tle9/Wall-E-Robot/Project Proposal/CS3651 Project Proposal.pdf

# CS 3651 - Prototyping Intelligent Devices Project Proposal Wall-E

### Names: Nithya Jayakumar, Tri Le

### March 4, 2024

## 1 Description

The project aims to construct a functional small-scale robot inspired by Wall-E, with a focus on mobility through the integration of distance sensors. The team envisions utilizing 3D printing technology to manufacture the robot’s chassis. Our goal is to meticulously recreate a miniaturized version of Wall-E, achieving a 90% replica in terms of functionality. While omitting features related to listening and solar panel functions, our primary objective is to develop a fully operational robot. One notable addition is the implementation of a notification system to alert users when the robot’s battery reaches a low level. This multifaceted project involves a combination of mechanical design, sensor integration, and programming to bring the mini Wall-E to life.


Figure 1: Wall-E in Movie.

## 2 Resources

1. DIY fully functional mini Wall-E using Arduino Nano - link (https://www.youtube.com/watch?v=iaqVNqsvQwI) & link (https://www.youtube.com/watch?v=Cqv2w0qYf-s)

This resource provides insights into the required parts and the overall functioning of a mini Wall-E using Arduino Nano. Our project will follow a similar concept, but with the added feature of autonomous movement.

2. 3D printed Wall-E replica tutorial - link (https://www.youtube.com/watch?v=SJ2odjtOjxY)

This tutorial guides the 3D printing process for a Wall-E replica. We plan to modify the provided CAD file to adapt the size and integrate our specific components for a smaller version of Wall-E.

3. 3D printed Wall-E with a list of components required and parts to make the robot fully functioning - link (https://wired.chillibasket.com/3d-printed-wall-e/) & link (https://youtu.be/ZRK9f4FZlD8)

This resource offers valuable information on the components required for a fully functioning 3D printed Wall-E. We will adapt the information to fit our project’s specifications, modifying motor sizes, battery sizes, and integrating sensors for autonomous movement.

4. Wall-E communication - link (https://blog.arduino.cc/2021/07/03/build-your-own-adorable-talking-wall-e-robot/)

This resource focuses on Wall-E’s communication abilities, including listening to commands and playing music. We plan to incorporate a similar communication system into our mini Wall-E for user interaction.

## 3 Design

The high-level design of the Wall-E robot encompasses several key components, each contributing to the overall functionality and appearance of the robot.

- Brain - Core Functionality
The brain of the Wall-E robot is the central unit responsible for controlling its movements, obstacle avoidance, and overall functionality. This component will utilize the following key elements:

– Arduino Nano: Serving as the primary microcontroller, the Arduino Nano will execute the robot’s code, coordinating various actions and responses.

– Bluetooth Chip: Enabling wireless communication, the Bluetooth chip allows for remote control and potential voice command input, facilitating user interaction.

– TOF (Time-of-Flight) Distance Sensor: This sensor is crucial for obstacle detection and avoidance, ensuring the robot can navigate its environment safely.

– H-Bridge: Responsible for controlling the DC motors that drive the robot’s movement, the H-Bridge facilitates precise control over speed and direction.


Figure 2: Wall-E Control Board/Brain

The code executed by the Arduino Nano will include algorithms for movement, obstacle detection, and interaction with other components, ensuring a seamless and intelligent behavior.

- Skeleton - Physical Movements
The skeleton of the Wall-E robot refers to its physical structure, incorporating movable components that bring the robot to life. This includes:

– Servos: Used to control the movement of the robot’s eyes, neck (up and down), head rotation, and arms, servos add dynamic and expressive qualities to the robot’s appearance.

– DC Motors: These motors drive the wheels, allowing the robot to move forward, backward, and turn in response to commands from the brain.

– Battery: Providing power to the motors, servos, and other electronic components, the battery ensures sustained operation.

– Speaker: The speaker is integrated for audio output, enabling the robot to produce sounds, potentially including Wall-E’s signature song.

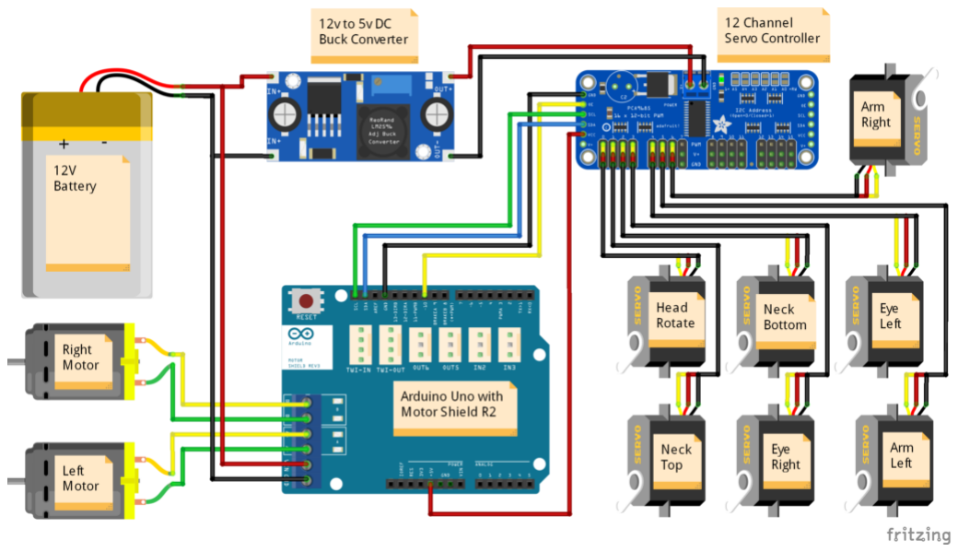
[picture p7: figure]

Figure 3: Skeleton diagram of the Wall-E robot. Note: Due to some parts changes, this diagram may not be fully accurate. It serves the purpose of illustrating the required components and their connections.

Assembling this skeleton involves careful placement and connection of components, considering balance and stability to achieve fluid and coordinated movements.

- Exterior - The ”Skin”
The exterior, or ”skin,” represents the outer appearance of the Wall-E robot. While this is a challenging aspect, it contributes significantly to the project’s aesthetics. The team plans to use 3D printing based on tutorials and CAD models, modifying them to fit the scaled-down version of Wall-E.


Figure 4: Example of 3D Printed Parts of Wall-E Robot.

However, due to limited experience with CAD, creating the exterior is marked as a ”stretch goal” for the project, acknowledging potential challenges and the need for additional learning and resources.


Figure 5: Example of 3D-printed WALL-E eyes with servos to control left and right eye movements, including sensors in both eyes.

- Voice Command (Stretch Goal)
If time allows, the team aims to implement a voice command feature, enabling the Wall-E robot to respond to spoken commands. This feature adds an interactive and user-friendly dimension to the robot’s capabilities. The voice command system may include recognizing phrases like ”move left,” ”move right,” ”stop,” ”forward,” ”backward,” and specific voice commands for the robot’s name and song playback.

This feature is designated as a ”stretch goal,” recognizing its complexity and potential for additional development beyond the primary project objectives.

In summary, the high-level design breaks down the Wall-E robot into its core components, addressing both functional and aesthetic aspects while also acknowledging potential challenges

and stretch goals.

### 3.1 Wall-E Parts Details

- Arduino Nano - link (https://www.amazon.com/Arduino-A000005-ARDUINO-Nano/dp/B0097AU5OU?hvadid=241907595991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) [x1]
- HM-10 Bluetooth Chip - link (https://www.amazon.com/DSD-TECH-Bluetooth-iBeacon-Arduino/dp/B06WGZB2N4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) [x1]
- H-Bridge [x1]
- AA battery [x4]
- Buck Converter - link (https://www.amazon.com/gp/product/B08Y674Z6F?linkId=9f7b55a9e0472ae92cea90d04bb54435&language=en_US) [x1]
- Servos - link (https://www.amazon.com/dp/B098FG3LJF?linkId=9cd9bc0acb06cb36fc01f502b2cd1ff1&language=en_US) [x5]
- 3V-6V DC Motors - link (https://www.amazon.com/dp/B09WMJJ8SF?linkId=741cfbc8d0840160116efdb36d687af6&language=en_US) [x2]
- Ultrasonic Sensor [x2]
- Others (bolt, nut, wire, resistors, lens, led, paper clips, etc)

### 3.1.1 Helpful Resources/Tutorial

- Wall-E Resources

1 How To Make a Baby Wall-E Robot (https://www.youtube.com/watch?v=Cqv2w0qYf-s)
2 3D Printed Wall-E (https://wired.chillibasket.com/3d-printed-wall-e/)
3 3D Wall-E CAD STEP file (https://drive.google.com/drive/folders/1AiicgyjlS-KWhi7NfhnoCsdB6uxxlqcq?usp=sharing)
4 3D Printed Wall-E - List of all components (https://wired.chillibasket.com/wp-content/uploads/2019/06/Wall-E-List-of-Parts.pdf) 5 Build an adorable, talking Wall-E robot (https://blog.arduino.cc/2021/07/03/build-your-own-adorable-talking-wall-e-robot/)
6 Laser vs Ultrasonic - TOF10120 vs. HC-SR04 (https://www.youtube.com/watch?v=xO5_3SjEhS4) 7 Baby Wall-E (Fully Functional) - 3D files (https://www.thingiverse.com/thing:5957438/files)
- CAD Modeling for 3D Printing Resources

1 Getting Started with CAD Modeling for 3D Printing (https://www.youtube.com/watch?v=IUoTKbGAlhk) 2 CAD TUTORIAL : FreeCAD Beginner [EASY GUIDE] (https://www.youtube.com/watch?v=1QNVyMBV0fM)
3 Tutorial - Step File Modeling Techniques (https://www.youtube.com/watch?v=vK-O7hwKYYQ)
4 FreeCAD for Beginners pt.7 - Importing .STEP files and Scaling (https://www.youtube.com/watch?v=Ae5O7j-hFwg)
- TOF Distance Sensor OR Ultrasonic Sensor

1 Arduino Laser Time-of-Flight Sensor Touch-Free Input Tutorial (https://www.youtube.com/watch?v=VnSfw9ynemc)
2 ESP8266 and Arduino Robotics: Measuring Distances w/ Ultrasonic Sensor HC-SR04 — WHEEL-E Robot (https://www.youtube.com/watch?v=ii5ofdo_968)
3 Obstacle Avoiding Robot Car Using An Arduino (https://www.youtube.com/watch?v=nUas-A0THDo)
4 ROOM MAPPING Arduino Robot (https://www.youtube.com/watch?v=4X_EjUZp2c0)
5 How To Make Arduino Human Following Robot (https://www.youtube.com/watch?v=yAV5aZ0unag) 6 Obstacle Avoiding Robot (Arduino) (https://www.instructables.com/Obstacle-Avoiding-Robot-Arduino-1/)

## 4 Expectations/Goals

The team’s goal is to build a fully functional WALL-E robot. However, as mentioned, the exterior part of the WALL-E robot will be optional (a stretch goal) due to the difficulty and limited 3D printing skills. The project of building a fully functional robot is already challenging. The challenges include obstacle avoidance, how motors/wheels will turn/run, how the ultrasonic screening/TOF sensor will work, and how to make it work, including mapping.
The team believes that to earn an ’A’ for this project, they must achieve the following:

a Implement a working robot ”brain” with code that makes the robot function similarly to the WALL-E robot.

b Ensure the ultrasonic/TOF sensor detects obstacles.

c Make the wheels turn, run, and stop based on the information gathered by the sensor.

d Implement robot mapping.

e Achieve a partially completed WALL-E exterior (not fully perfect).

However, the team recognizes that to earn a perfect ’A’ for this project, they need to have a fully completed 3D printed exterior of the WALL-E robot.

Additionally, the team believes there can be a bonus for the project if they are able to make the robot a rechargeable hub. The robot would autonomously return to recharge its battery when low, and the charging hub would utilize a solar panel (similar to the movie). WALL-E should also be able to communicate by listening to voice commands for turning, running, stopping, moving backward, playing a song, and saying its name when asked.

## 5 Mid-Project Deliverable

For the mid-project deliverable, the team aims to accomplish the following:

1 Complete the construction of the robot’s brain, including wiring, soldering parts, and assembling the components.

2 Partially 3D print the robot’s exterior.

3 Enable the robot to move left, right, and stop using sensors, and ensure it can avoid obstacles.

4 Fully complete the robot’s skeleton, including the integration of the battery.

5 Ensure that all servos, motors, and sensors work as expected.
