tle9/Wall-E-Robot/CS3651 Project Final Deliverable/Baby Wall-E Final Project Demo.pdf

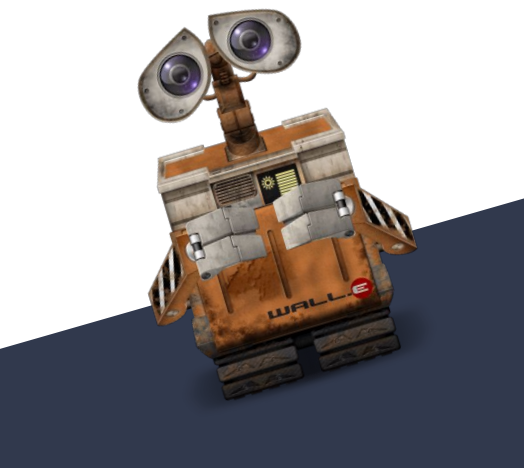
[picture p8: figure]

# Baby Wall-E

Tri Le and Nithya Jayakumar

# Motivation

### Picture this:

A world overflowing with garbage. Humans can no longer live on the planet. And we are in a giant spaceship in outer space, orbiting the Earth

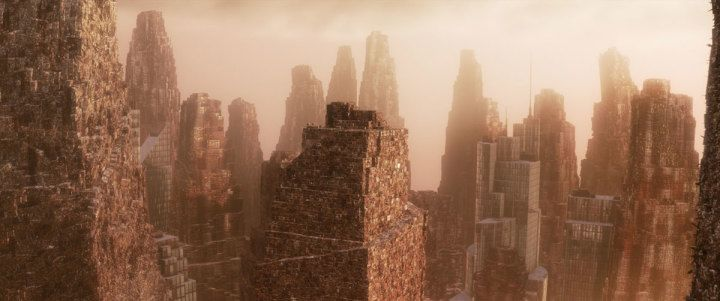
[picture p9: figure]

# The Solution

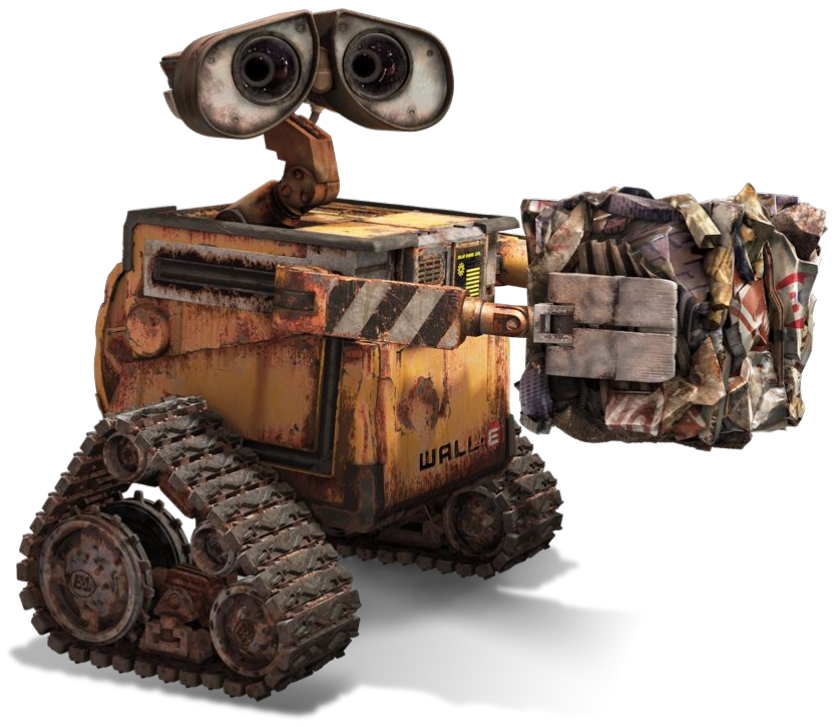
[picture p10: figure]

## Baby Wall-E

# Baby Wall-E

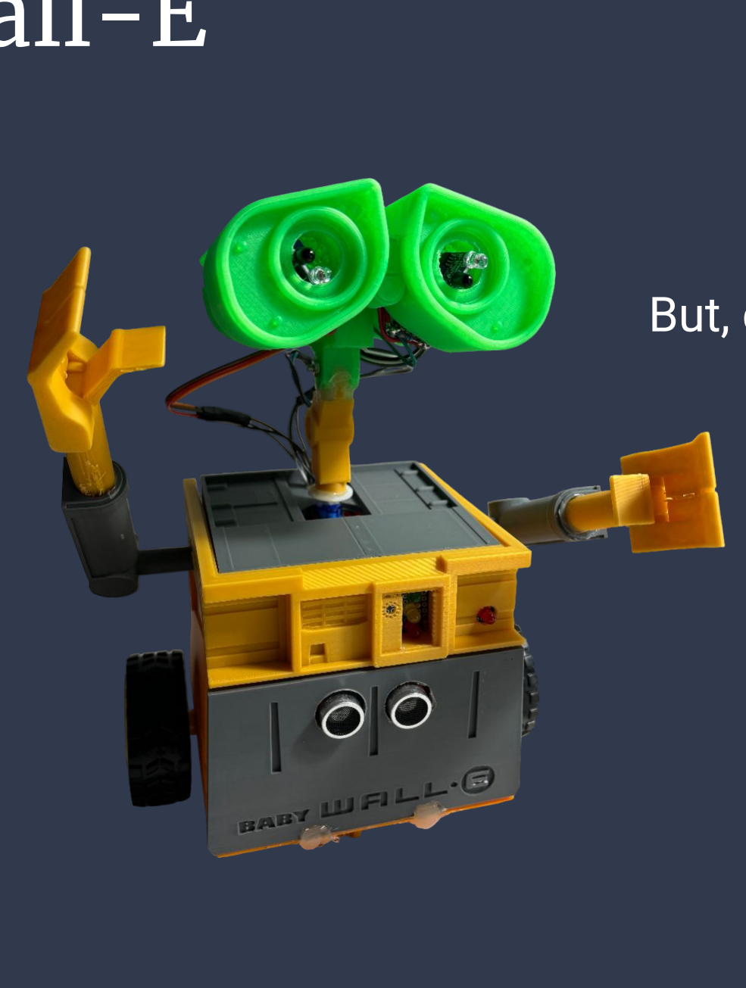
[picture p11: figure]

But, can this Baby Wall-E actually shovel trash?

Sadly no, not at this current state. But, isn’t he so cute?

# Implementation

- We built an autonomous obstacle-avoidance robot. Also known as Baby Wall-E.
- Some major components:
- Arduino Nano
- Ultrasonic Sensor
- DC Motors
- Infrared Sensors

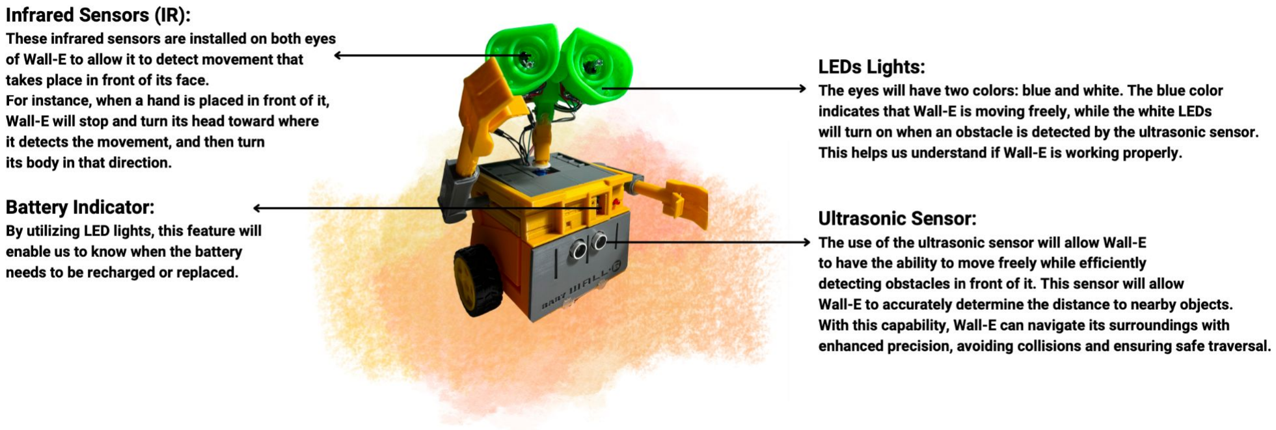
[picture p12: figure]

We found the CAD file for the 3D Baby Wall-E parts online and made changes to the 3D printed parts to fit the ultrasonic sensor, IR sensors, LEDs lights, and battery check (which were not part of the original design). Additionally, we modified it to accommodate a larger battery size than what it was originally designed for.

We coded everything ourselves. The only two libraries we used for the code are Servo.h and NewPing.h

The Servo.h library helps us control the servos for the arms and head of the robot, while we use NewPing.h for the ultrasonic sensor.

# Problems

and Solutions | ● | Wheel Tracks: Initially, we had printed tracks for the robot, but the motor axles weren't long enough to hold them. ○ Various attempts to fix this, including using hot glue and epoxy, were unsuccessful due to the motors not being suitable for our robot's size. We switched to using robot wheels instead.
- Soldering: While soldering wires for the Arduino, some
| | were accidentally broken and not initially visible. ○ After resoldering, we discovered two wires for the H-bridge were burned and not connected to the Arduino.
- Battery: We faced issues with battery couldn't power all
| | components. ○ We added an extra one to power all the servos.

# Demo

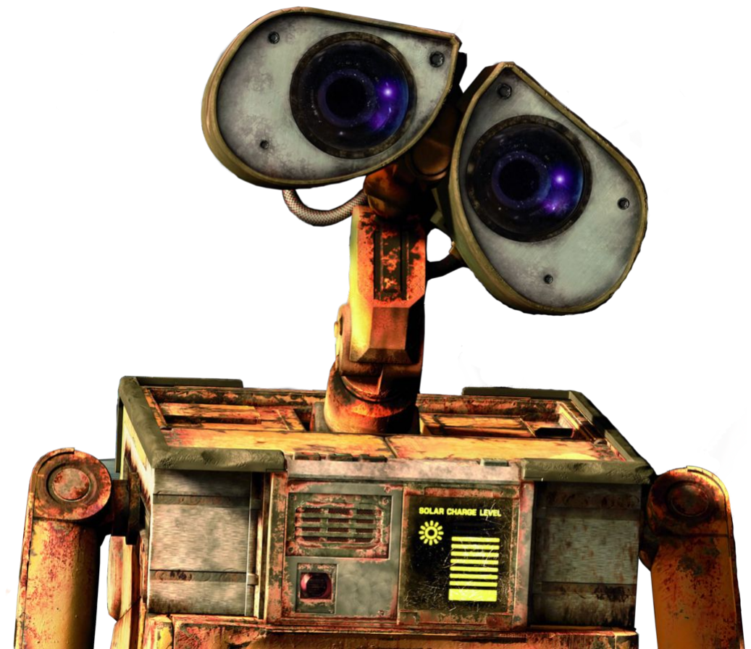
[picture p13: figure]
