tle9/Wall-E-Robot/CS3651 Project Mid Review/CS3651 Mid Project Review.pdf

# CS 3651 - Prototyping Intelligent Devices Mid-Project Review Wall-E

### Names: Nithya Jayakumar, Tri Le

### April 1, 2024

1. A high-level design of the Wall-E Robot:

– The electronic parts that are currently use

1) Arduino Nano [x1]
+ Serving as the primary microcontroller, the Arduino Nano will execute the robot’s code, coordinating various actions and responses.
2) Buck Converter [x1]
+ Serving as voltage converter from the AA batteries to the Arduino and other electronic parts.
3) DC Geared Motors [x2]
+ These motors drive the wheels, allowing the robot to move forward, backward, and turn in response to objects detect by the Ultrasonic sensor.
4) Servos [x3]
+ Used to control the movement of the robot’s head rotation, and arms, servos add dynamic and expressive qualities to the robot’s appearance.
5) Ultrasonic Sensor [x1]
+ This sensor allow the robot to detect obstacles and avoidance it, allow it move safely.
6) Infrared Sensors (IR) [x2]
+ The IR sensors will placed near the robot eye, since it can’t detect far object, this sensors purpose as something the user can interact with the robot, example hand movement in front of the robot, allow the robot to rotate it head and body to where the hand at.
7) Buzzer [x1]
+ This will make some sounds for the robot.
9) H-Bridge [x1]
+ This will responsible for controlling the DC motors that drive the robot’s movement, the H-Bridge facilitates precise control over speed and direction..
10) Red, Yellow and Green LEDs [x1]
+ These LEDs will serve as battery level check, since Wall-E have the battery level display, this is somewhat serve same purpose.
11) Blue and White LEDs [x1]
+ These LEDs will be the robot eyes, nornmal is blue, and when there is object detect, it will change to white.

How they will be electrically connected, at a high level


– What software libraries you are using

+ Servo.h and NewPing.h

– What mechanical parts you plan to make

+ Battery Compartment - a compartment will be designed to securely hold the AA batteries, ensuring they are protected and easily accessible for replacement when needed.
+ Modified Wall-E Eye - the eye of the Wall-E Robot will be modified to accommodate LEDs and IR sensors. This modification will enhance the robot’s functionality and interaction capabilities.
+ Body Modification for Sensors and LEDs - part of the robot’s body will be modified to house the ultrasonic sensor and LEDs for battery indication.
2. Team progress:

– Any goals already achieved from your proposal: Yes, several milestones outlined in the proposal have been successfully completed:

+ Constructed the robot’s brain, including wiring, soldering parts, and assembling components.
+ Partially 3D printed the robot’s exterior, including body parts, wheels, and tracks. Other parts are currently in the printing process.

+ Implemented basic movement capabilities: the robot can move forward and detect obstacles using the ultrasonic sensor, turning left or right when obstacles are detected.
+ Implemented functionality for the IR sensor and head servo: when a hand is detected close to the eye, the head and body move in that direction. Further improvements are in progress.
+ The team is currently revising electronic parts and finalizing wire soldering.

– Physical components of the project that you have:

a) Have in-hand:
+ Servos, ultrasonic sensor, IR sensors, buck converter, Arduino Nano, buzzer, DC geared motors, H-bridge, LEDs.
b) Have tested:
+ IR sensor and servo functionality.
+ LEDs for battery level indication.
c) Have integrated
+ Arduino Nano.
+ H-bridge with DC geared motors for movement control. + Servos for head and arm movement.
+ Ultrasonic sensor for obstacle detection.
+ Buck converter and AA batteries for power supply.
3. Difficulties encountered:

– Ways we can work around parts of your original design that aren’t going to come together in time

- In the team proposal, we said we would implement mapping for the robot. However, after discussions with the TA and Scott, we believe it’s best to leverage the use of sensors instead. This approach would be more feasible and effective. Additionally, while our proposal mentioned the use of Bluetooth, we still aim to incorporate something similar for the final deliverable if time allows.

– Is there anything you wish was covered in a skill demo?

- Perhaps demonstrating how to desolder components could be valuable. Additionally, covering how to properly utilize batteries with Arduino would be beneficial.
- Additionally, it would have been helpful to have a skill demo that deals with assembling mechanical parts in order to understand and internalize concepts such as space for wiring and parts as well as connections
