tle9/Wall-E-Robot/CS3651 Project Mid Review/Screenshot 2024-03-25 at 4.13.28 PM.png

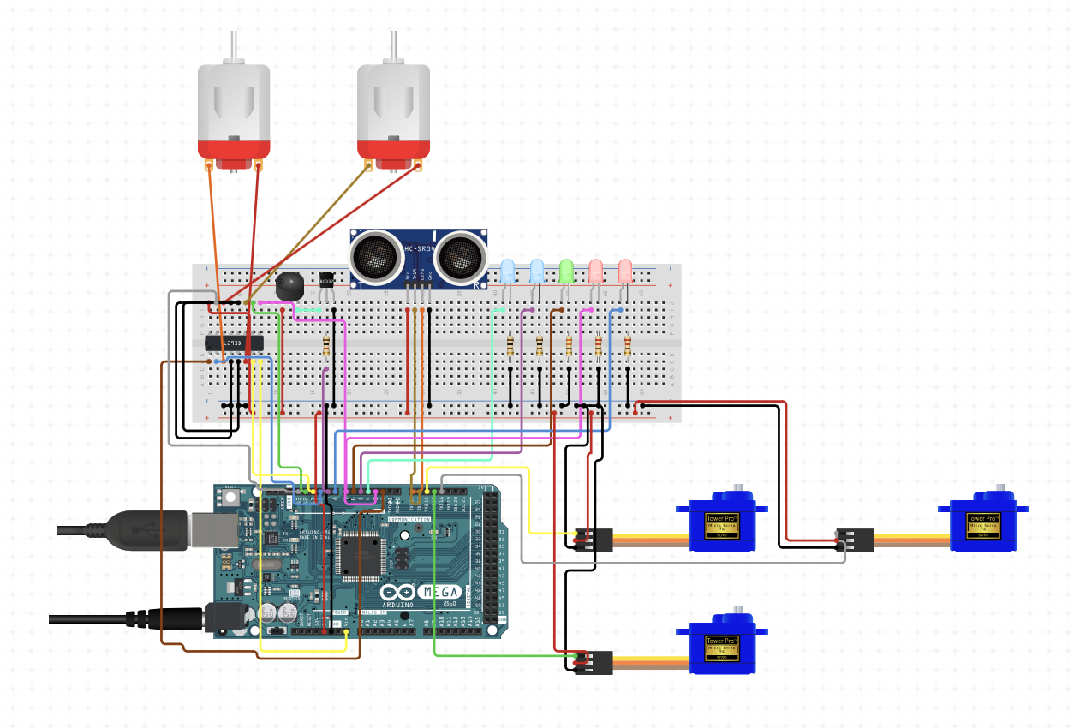
CS3651 Project Mid Review/Screenshot 2024-03-25 at 4.13.28 PM.png
